DamonT17/Autonomous-Delivery-Robot/GUI/ADR GUI/build/classes/my/ADR/Images/ADR_bg.jpg

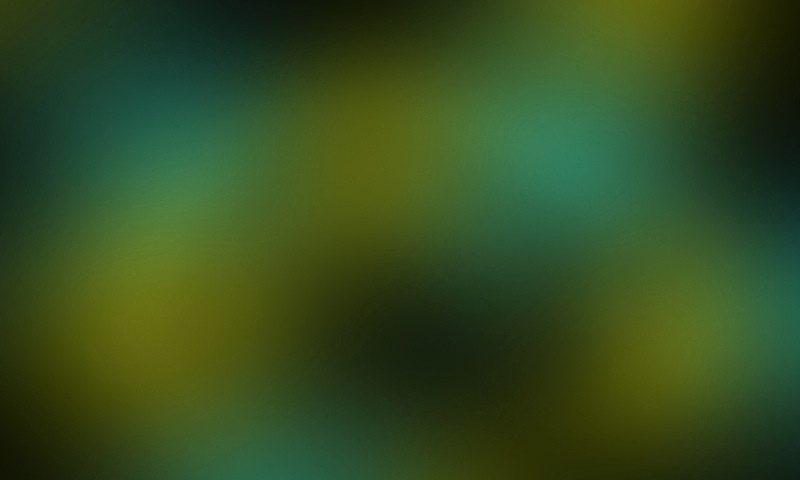
GUI/ADR GUI/build/classes/my/ADR/Images/ADR_bg.jpg
