DamonT17/Autonomous-Delivery-Robot/Documentation/WBS/WBS.pdf

ID | Task
Mode
| Task Name | Duration | Start | Finish
1 | Autonomous Delivery Robot | 72 days | Sun 9/3/17 | Fri 12/8/17
2 | Physical Build | 51 days | Sun 10/1/17 | Fri 12/8/17
3 | Screen Mount | 7 days | Sun 10/1/17 | Sat 10/7/17
4 | Item Compartment | 7 days | Sun 10/8/17 | Sat 10/14/17
5 | Room Recognition | 72 days | Sun 9/3/17 | Fri 12/8/17
6 | Research and Purchase RFID | 7 days | Sun 9/3/17 | Sat 9/9/17
7 | RFID Hardware Setup | 7 days | Sun 9/17/17 | Sat 9/23/17
8 | RFID Software Setup | 61 days | Sun 9/17/17 | Fri 12/8/17
9 | Single Room Recognition | 7 days | Sun 9/17/17 | Sat 9/23/17
10 | Double Room Recognition | 7 days | Sun 9/24/17 | Sat 9/30/17
11 | Multiple Recognition | 27 days | Sun 10/1/17 | Sat 11/4/17
12 | Motor Communication | 26 days | Sun 11/5/17 | Fri 12/8/17
13 | Graphical User Interface | 43 days | Sun 9/10/17 | Sun 11/5/17
14 | Java Pi Installation | 7 days | Sun 9/10/17 | Sat 9/16/17
15 | Splash Screen | 7 days | Sun 9/17/17 | Sat 9/23/17
16 | Home Screen | 7 days | Sun 9/24/17 | Sat 9/30/17
17 | User Input Screen | 7 days | Sun 10/1/17 | Sat 10/7/17
18 | Driving Screen | 7 days | Sun 10/8/17 | Sat 10/14/17
19 | Unlock Screen | 7 days | Sun 10/15/17 | Sat 10/21/17
20 | Wifi Security Texting | 12 days | Sun 10/22/17 | Sun 11/5/17
21 | Firmware | 72 days | Sun 9/3/17 | Fri 12/8/17
22 | Library Implementation | 72 days | Sun 9/3/17 | Fri 12/8/17
23 | Motor | 7 days | Sun 9/10/17 | Sat 9/16/17

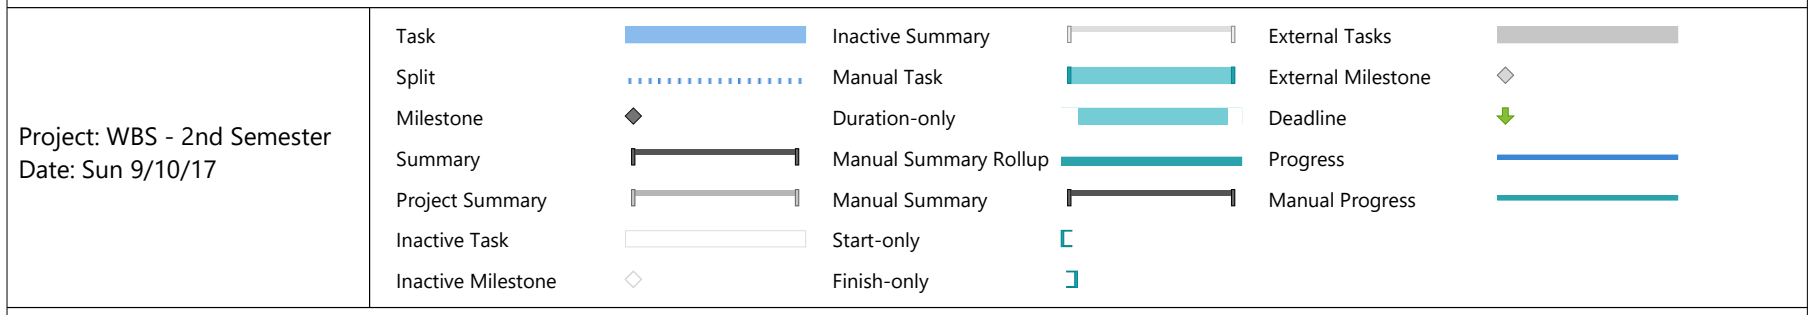
[picture p35: figure]
Task; Split; Milestone; Summary; Project Summary; Inactive Task; Inactive Milestone; Inactive Summary; Manual Task; Duration-only; Manual Summary Rollup; Manual Summary; Start-only; Finish-only; External Tasks; External Milestone; Deadline; Progress; Manual Progress; Project: WBS - 2nd Semester Date: Sun 9/10/17

ID | Task
Mode
| Task Name | Duration | Start | Finish
24 | Ultrasonic Sensors | 7 days | Sun 9/17/17 | Sat 9/23/17
25 | RFID | 7 days | Sun 11/5/17 | Sat 11/11/17
26 | Tunning | 72 days | Sun 9/3/17 | Fri 12/8/17
27 | Business Adminstration and Procurment | 72 days | Sun 9/3/17 | Fri 12/8/17

Person

## JAMD Justin/Michael Justin/Michael Justin Austin/Justin Austin/Justin Austin/Justin Austin/Justin Austin/Justin Austin/Justin Austin/Justin Austin/Justin/Damon Michael/Damon Michael/Damon Michael/Damon Michael/Damon Michael/Damon Michael/Damon Michael/Damon Michael/Damon JAMD Damon/Michael Damon

F | S | S | M | T | W | T | F | S | S | M | T | W | T | F | S | S | M | T | W | T | F | S | S | M | T | W | T | F | S | S
Sep 3, '17 | Sep 10, '17 | Sep 17, '17 | Sep 24, '17 | Oct 1, '17

Person

## Damon Damon JAMD Michael

F | S | S | M | T | W | T | F | S | S | M | T | W | T | F | S | S | M | T | W | T | F | S | S | M | T | W | T | F | S | S
Sep 3, '17 | Sep 10, '17 | Sep 17, '17 | Sep 24, '17 | Oct 1, '17

S | M | T | W | T | F | S | S | M | T | W | T | F | S | S | M | T | W | T | F | S | S | M | T | W | T | F | S | S | M | T | W | T | F | S
Oct 1, '17 | Oct 8, '17 | Oct 15, '17 | Oct 22, '17 | Oct 29, '17

Oct 1, '17 | Oct 8, '17 | Oct 15, '17 | Oct 22, '17 | Oct 29, '17

Nov 5, '17 | Nov 12, '17 | Nov 19, '17 | Nov 26, '17 | Dec 3, '17

Nov 5, '17 | Nov 12, '17 | Nov 19, '17 | Nov 26, '17 | Dec 3, '17
